TimurMuhanov/nio-15-stand/documentation/board/SERVO-1.docx

Плата контроллера SERVO-1, схема электрическая принципиальная

Примечание: 2 платы собираются бутербродом, на стойках, красными слоями плат (см. разводку) друг к другу. Между платами расстояние около 10 мм (по высоте соединительного разъёма). Платы соединяются электрически штыревым разъёмом. Направления нос-хвост указаны на рисунках.

Посадка плат на старый крепёжный уголок. Размеры плат пришлось увеличить на 3 мм в длину и ширину.

Плата периферийных устройств SERVO-2, схема электрическая принципиальная

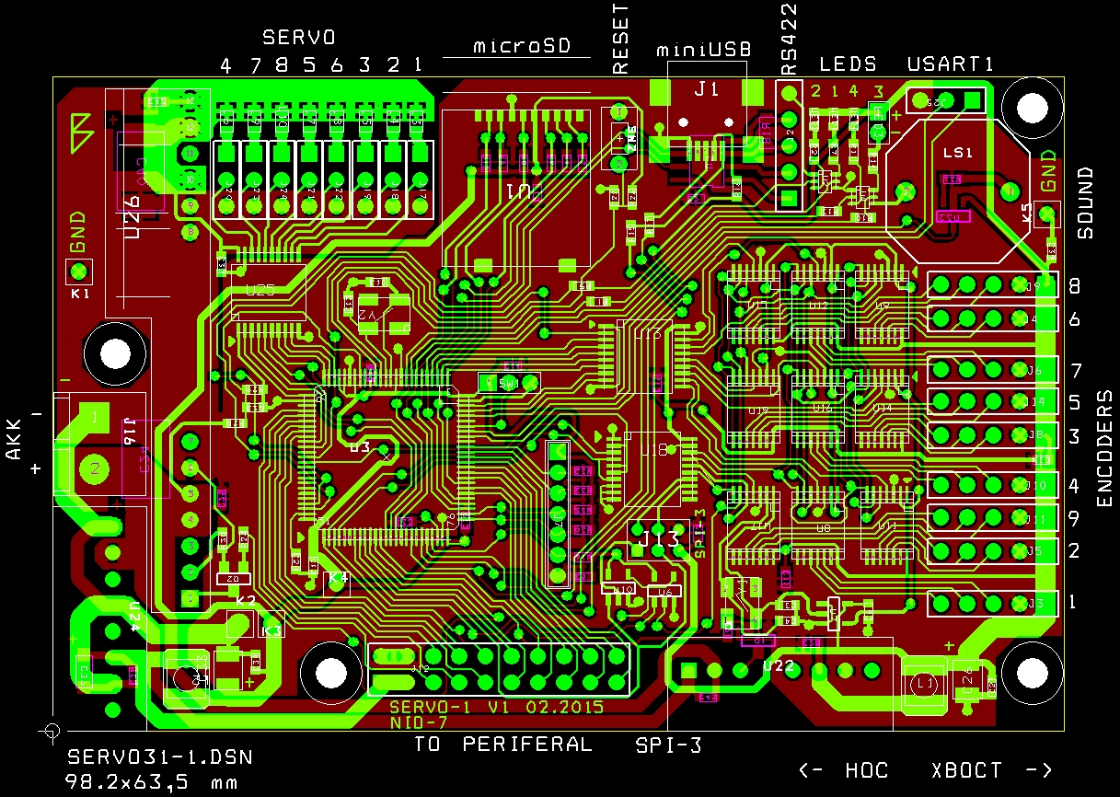
[picture p2: figure]

Разводка платы контроллера.

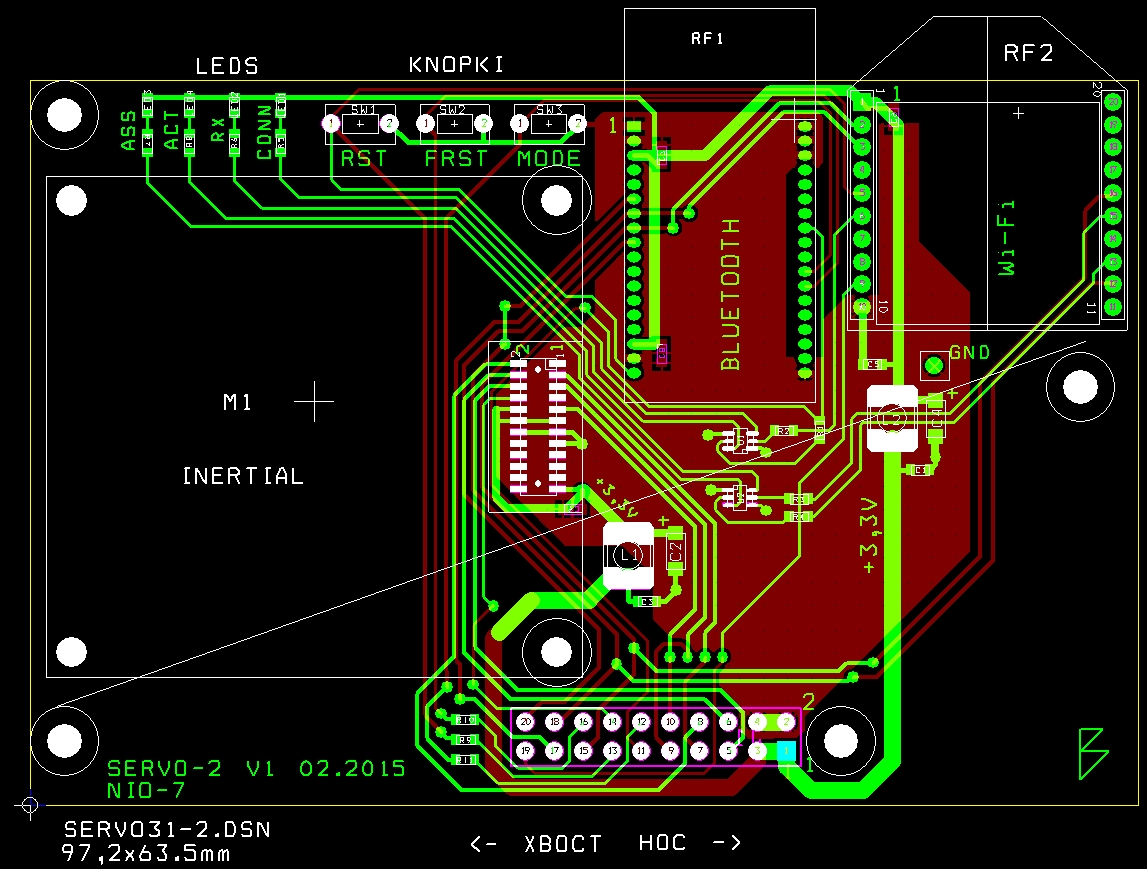
[picture p3: figure]

Разводка платы периферии
