TimurMuhanov/nio-15-stand/documentation/board/scheme1.png

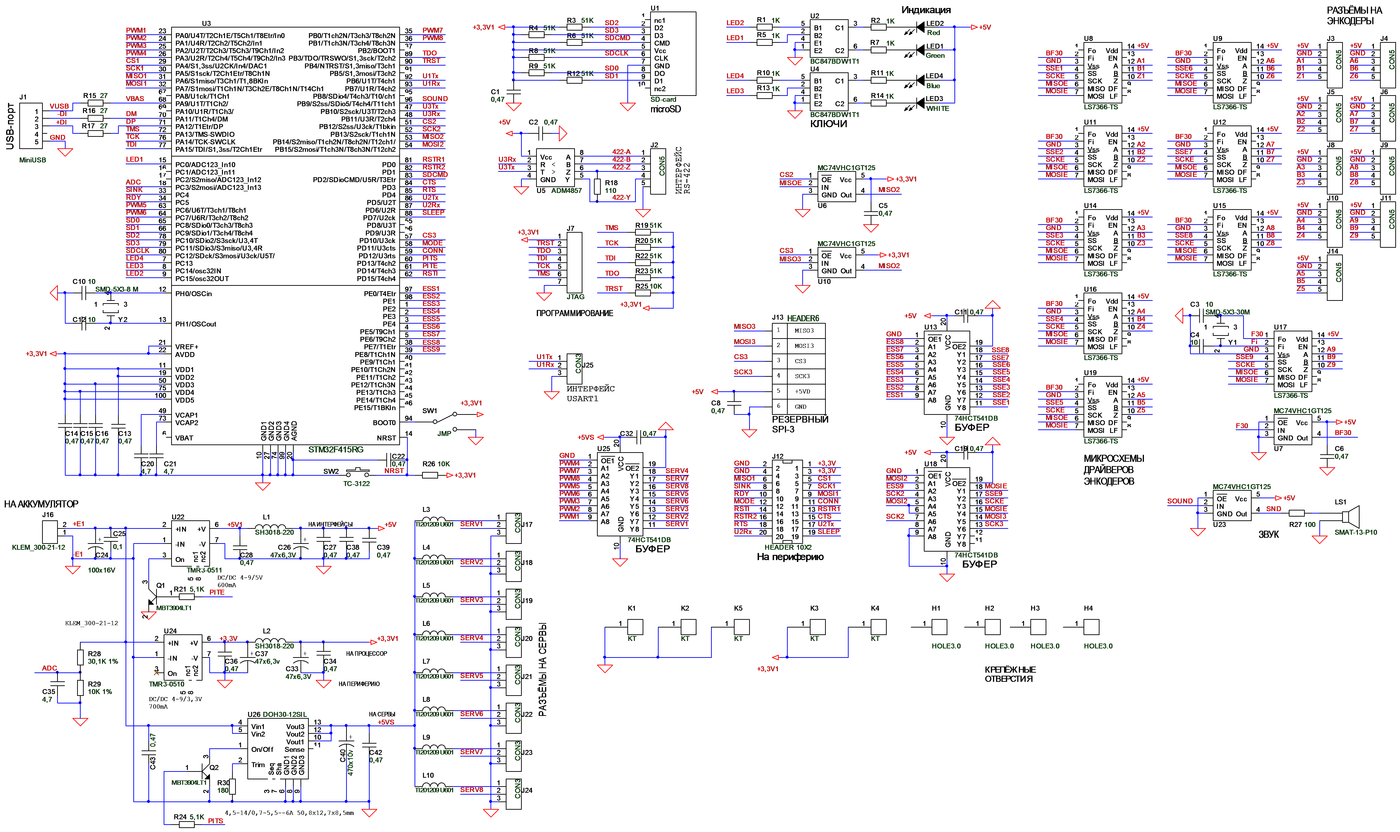
documentation/board/scheme1.png
