TimurMuhanov/nio-15-stand/documentation/board/scheme2.png

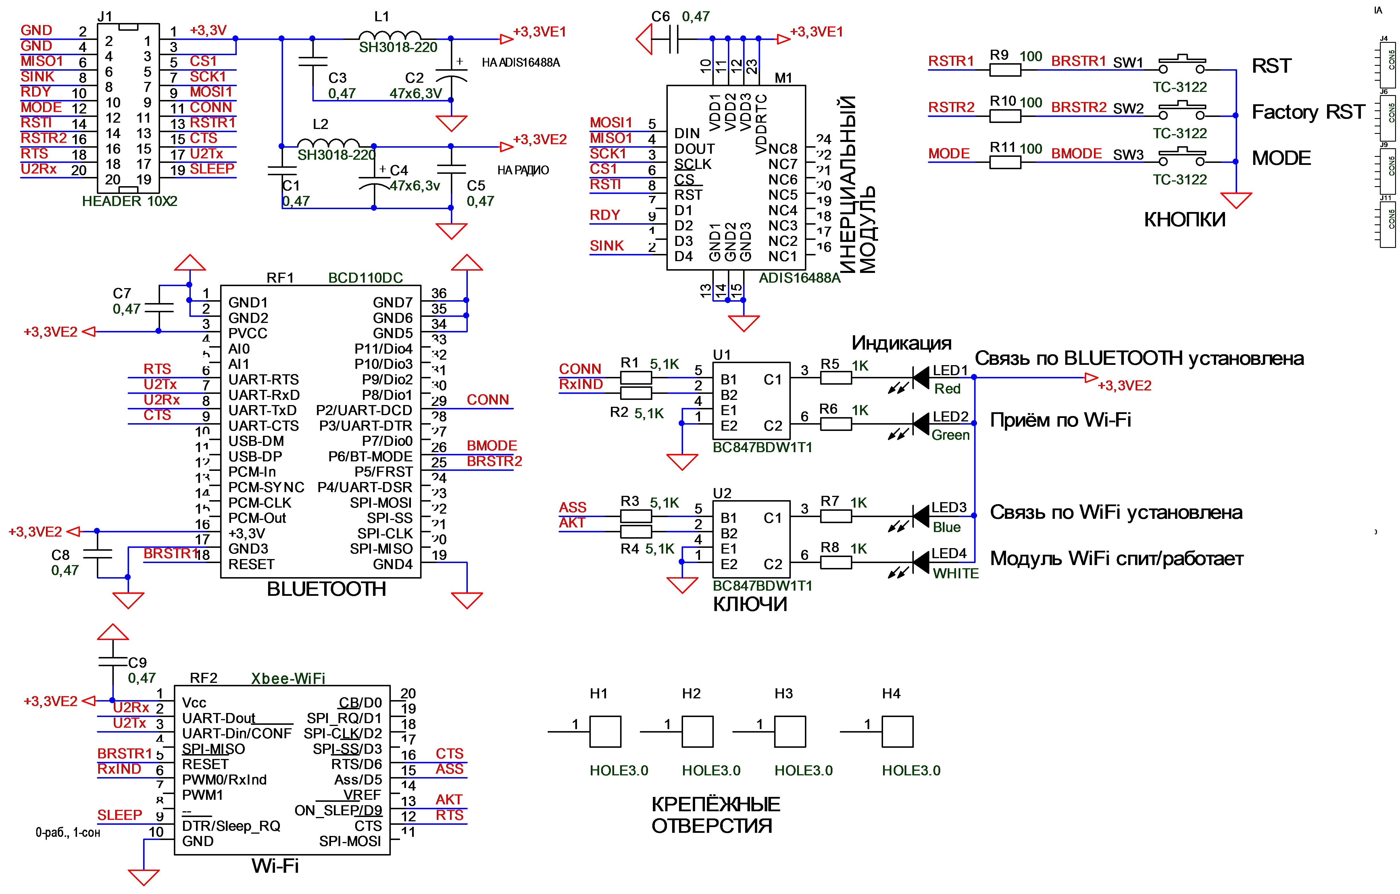
documentation/board/scheme2.png
