TimurMuhanov/nio-15-stand/firmware/driver/include/driver.h

/**	@defgroup	DRIVER
	@author		Zaripov Kamil
	@brief		Contain hardware layer
	@{ */
	
#ifndef DRIVER_H
#define DRIVER_H

#include "Battery.h"
#include "adis16488.h"
#include "led.h"
#include "ls7366.h"

#endif

/** @} */
