TimurMuhanov/nio-15-stand/firmware/system/PubSub.cpp

#include "PubSub.h"

//Topic<vectorData> Topics::accel;
//Topic<vectorData> Topics::gyro;
//Topic<vectorData> Topics::mag;
//Topic<scalarData> Topics::temp;
//Topic<scalarData> Topics::press;
//Topic<quaternionData> Topics::quat;
