TimurMuhanov/nio-15-stand/firmware/system/include/system.h

/**	@defgroup	SYSTEM
	@author		Zaripov Kamil
	@brief		Contain hardware-independent layer
	@{ */
	
#ifndef SYSTEM_H
#define SYSTEM_H

#include "Terminal.h"
#include "FileSystem.h"
#include "Connection.h"
#include "Settings.h"
#include "Log.h"
#include "Control.h"

#endif

/** @} */
