TimurMuhanov/nio-15-stand/firmware/system/include/thread.h

/**	@defgroup	CONNECTION
	@author		Zaripov Kamil
                API for threading
	@{ */

#ifndef THREAD_H
#define THREAD_H

#include "ch.hpp"
#include "chdynamic.h"
#include "hal.h"
#include <string>
#include <map>

using namespace std;

class Thread {
    public:
        static void                     loop();
};

#endif

/** @} */
