TimurMuhanov/nio-15-stand/gcs/connection/include/logger.h

#ifndef	LOGGER_H
#define	LOGGER_H


#include <QObject>
#include <QHash>
#include <QFile>


class Logger : public QObject {
    Q_OBJECT

    public:
        static Logger&			instance();

    public slots:
        void					addData(const QString& name, const double time, std::initializer_list<double> data);

    private slots:
        void                    reset();
        void                    loggingPathChange();

    private:
                                Logger(QObject *parent = 0);
                               ~Logger();
                                Logger(Logger const&);
                                Logger& operator= (Logger const&);

        QString					_rootPath;
        QString					_path;
        QHash<QString, QFile*>  _logs;
};


#endif // LOGGER_H
