TimurMuhanov/nio-15-stand/simulator/calculator/calculator.cpp

#include "calculator.h"
#include "ui_mainwindow.h"



Calculator::Calculator(QObject* parent) : QThread(parent) {
	QObject::connect(
		MainWindow::ui().startPushButton,
		SIGNAL(clicked()),
		SLOT(startStop())
	);

	QObject::connect(
		this,
		SIGNAL(newPlot(QString, double, double)),
		&MainWindow::instance(),
		SLOT(plotAdd(QString, double, double))
	);


	QObject::connect(
		this,
		SIGNAL(started()),
		this,
		SLOT(startUI())
	);
	QObject::connect(
		this,
		SIGNAL(finished()),
		this,
		SLOT(stopUI())
	);

	_isStop = false;
}

Calculator::~Calculator() {
	_isStop = true;
	wait(CALCULATOR_CLOSE_WAIT_TIME_MS);
}

Calculator& Calculator::instance() {
	static Calculator instance;
	return instance;
}

void Calculator::run() {
	while(1) {
		//qDebug() << timeAt << dtAt << timeAl << dtAl;
		if( timeAt <= timeAl && timeAl < timeAt+dtAt ) {
			updateAlgorythm();
			timeAl+=dtAl;
		}
		timeAt+=dtAt;

		// debug
		emit newPlot("mx", timeAt, Mx);
		emit newPlot("my", timeAt, My);
		emit newPlot("mz", timeAt, Mz);
		//qDebug() << "M" << Mx << My << Mz;
		emit newPlot("wx", timeAt, wx);
		emit newPlot("wy", timeAt, wy);
		emit newPlot("wz", timeAt, wz);
		//qDebug() << "w" << wx << wy << wz;
		emit newPlot("psi", timeAt, psi/M_PI*180.0);
		emit newPlot("theta", timeAt, theta/M_PI*180.0);
		emit newPlot("gamma", timeAt, gamma/M_PI*180.0);
		//qDebug() << "a" << psi/M_PI*180.0 << theta/M_PI*180.0 << gamma/M_PI*180.0;

		// calculate moments
		aer_loads_mig29_moments( atan(tan(theta)*cos(gamma))/M_PI*180.0, asin(sin(theta)*sin(gamma))/M_PI*180.0, wx*L/2/V, wy*L/2/V, wz*ba/V, fi, df, da, dr, -0.0177 );

		// calculate angular rate
		wx = wxPrevious+(wyPrevious*wzPrevious*(Jy-Jz)/Jx+Mx/Jx)*dtAt;
		wy = wyPrevious+(wzPrevious*wxPrevious*(Jz-Jx)/Jy+My/Jy)*dtAt;
		wz = wzPrevious+(wxPrevious*wyPrevious*(Jx-Jy)/Jz+Mz/Jz)*dtAt;

		wxPrevious = wx;
		wyPrevious = wy;
		wzPrevious = wz;

		// calculate angles
		psi = psiPrevious+( (wz*sin(gammaPrevious)-wy*cos(gammaPrevious))/sin(thetaPrevious) )*dtAt;
		theta = thetaPrevious+( wy*sin(gammaPrevious)+wz*cos(gammaPrevious) )*dtAt;
		gamma = gammaPrevious+( wx+(wy*cos(gammaPrevious)-wz*sin(gammaPrevious))*cos(thetaPrevious)/sin(thetaPrevious) )*dtAt;

		if( abs(psi)>2*M_PI ) psi= fmod(psi, 2*M_PI);
		if( abs(theta)>2*M_PI ) theta= fmod(theta, 2*M_PI);
		if( abs(gamma)>2*M_PI )	gamma= fmod(gamma, 2*M_PI);
		psiPrevious = psi;
		thetaPrevious = theta;
		gammaPrevious = gamma;

		if( _isStop || timeAt > MainWindow::ui().endTimeSpinBox->value() ) {
			_isStop = false;
			return;
		}
	}
}

extern float vDelta_o[6];
extern float dt;

void Calculator::startStop() {
	if( isRunning() ) {
		_isStop = true;
		wait(CALCULATOR_CLOSE_WAIT_TIME_MS);
	} else {
		reset();
		start();
	}
}

void Calculator::startUI() {
	MainWindow::ui().inputGroupBox->setEnabled(false);
	MainWindow::ui().startPushButton->setText("Pause");
}

void Calculator::stopUI() {
	MainWindow::ui().inputGroupBox->setEnabled(true);
	MainWindow::ui().startPushButton->setText("Start");
}



typedef struct { 		         // input data struct
	 float W[3];        // wx, wy, wz до фильтра Калмана [deg/s]
	 float Wk[3];       // wx, wy, wz после фильтра Калмана [deg/s]
	 float PHI[3];      // gamma, teta, psi от фильтра Калмана [deg]
	 float encData[3];  // данные - encoder1,2,3 [deg]
	 // encoder1 - крен
	 // encoder2 - рыскание
	 // encoder3 - тангаж
} _DLMIN;

typedef struct { 		         // out data struct
	 float ANGL[6];	     // углы отклонения органов управления в [deg]
	 // 1 - правый элерон			0
	 // 2 - стабилизатор правый	1
	 // 3 - левый элерон			2
	 // 4 - руль направления		3
	 // 5 - стабилизатор левый		4
	 // 6 - не используется		5
} _DLMOUT;
_DLMIN InData;
_DLMOUT OutData;

extern "C" int umain(const _DLMIN *InData, _DLMOUT *OutData);

void Calculator::updateAlgorythm() {
	InData.Wk[0] = wx;
	InData.Wk[1] = wy;
	InData.Wk[2] = wz;
	InData.encData[0] = gamma;
	InData.encData[1] = psi;
	InData.encData[2] = theta;
	//qDebug() << "input" << InData.encData[0] << InData.encData[1] << InData.encData[2];
	umain( (const _DLMIN*)&InData, (_DLMOUT*)&OutData);
	//   fi - angle of GO deflection (deg) [-35deg 10deg]
	//   df - differentional GO deflection (deg)
	//   da - aileron deflection (deg) [-20deg 20deg]
	//   dr - rudder deflection (deg) [-25deg 25deg]

	//qDebug() << "output" << OutData.ANGL[0] << OutData.ANGL[1] << OutData.ANGL[2] << OutData.ANGL[3] << OutData.ANGL[4] << OutData.ANGL[5];
	fi = (OutData.ANGL[1]+OutData.ANGL[4])/2;
	df = (OutData.ANGL[1]-OutData.ANGL[4])/2;
	da = (OutData.ANGL[0]-OutData.ANGL[2])/2;
	dr = OutData.ANGL[3];

	emit newPlot("fi", timeAt, fi);
	emit newPlot("df", timeAt, df);
	emit newPlot("da", timeAt, da);
	emit newPlot("dr", timeAt, dr);
	emit newPlot("servo1", timeAt, OutData.ANGL[0]);
	emit newPlot("servo2", timeAt, OutData.ANGL[1]);
	emit newPlot("servo3", timeAt, OutData.ANGL[2]);
	emit newPlot("servo4", timeAt, OutData.ANGL[3]);
	emit newPlot("servo5", timeAt, OutData.ANGL[4]);
}

void Calculator::reset() {
	Jx = MainWindow::ui().JxDoubleSpinBox->value();
	Jy = MainWindow::ui().JyDoubleSpinBox->value();
	Jz = MainWindow::ui().JzDoubleSpinBox->value();
	rho = MainWindow::ui().rhoDoubleSpinBox->value();
	V = MainWindow::ui().VDoubleSpinBox->value();
	S = MainWindow::ui().SDoubleSpinBox->value();
	L = MainWindow::ui().LDoubleSpinBox->value();
	ba = MainWindow::ui().baDoubleSpinBox->value();

	Mx = MxPrevious = 0;
	My = MyPrevious = 0;
	Mz = MzPrevious = 0;

	wx = wxPrevious = MainWindow::ui().wxDoubleSpinBox->value();
	wy = wyPrevious = MainWindow::ui().wyDoubleSpinBox->value();
	wz = wzPrevious = MainWindow::ui().wzDoubleSpinBox->value();

	theta = thetaPrevious = (MainWindow::ui().thetaDoubleSpinBox->value())/180*M_PI;
	psi = psiPrevious = (MainWindow::ui().psiDoubleSpinBox->value())/180*M_PI;
	gamma = gammaPrevious = (MainWindow::ui().gammaDoubleSpinBox->value())/180*M_PI;

	dtAt = MainWindow::ui().tAtDoubleSpinBox->value();
	dtAl = MainWindow::ui().tAlDoubleSpinBox->value();
	timeAl = 0;
	timeAt = 0;

	fi = MainWindow::ui().fiDoubleSpinBox->value();
	df = MainWindow::ui().dfDoubleSpinBox->value();
	da = MainWindow::ui().daDoubleSpinBox->value();
	dr = MainWindow::ui().drDoubleSpinBox->value();
	vDelta_o[0] = da;
	vDelta_o[2] = -da;
	vDelta_o[1] = fi+df;
	vDelta_o[3] = dr;
	vDelta_o[4] = fi-df;
	dt = dtAl;

	MainWindow::instance().reset();
}




void Calculator::aer_loads_mig29_moments( double al, double be, double wx, double wy, double wz, double fi, double df, double da, double dr, double dx ) {
	//qDebug() << "aer_loads_mig29_moments" << al << be << wx << wy << wz << fi << df << da << dr << dx;
	// MIG-29 low subsonic aerodynamic loads mathematical model (Syrovatsky)
	//   Input
	//   al - angle of attack (deg) [-5deg 90deg]
	//   be - angle of sideslip (deg) [-20deg 20deg]
	//   wx - roll rate (undimensioanal)
	//   wy - yaw rate (undimensioanal)
	//   wz - pitch rate (undimensioanal)
	//   fi - angle of GO deflection (deg) [-35deg 10deg]
	//   df - differentional GO deflection (deg)
	//   da - aileron deflection (deg) [-20deg 20deg]
	//   dr - rudder deflection (deg) [-25deg 25deg]
	//   dx - CG position displacement
	//   Output
	//   cx - aeodynamic drag coefficient in body fixed frame
	//   cy - aeodynamic drag coefficientin body fixed frame
	//   cz - aeodynamic drag coefficientin body fixed frame
	//   mx - rolling moment coefficient in body fixed frame
	//   my - yawing moment coefficient in body fixed frame
	//   mz - pitching moment coefficient in body fixed frame

	double cx, cy, cz, mx, my, mz;

	cx = cx_al(al);
	cy = cy_al_fi(al,fi);
	cz = cz0(al) + dcz_al_be(al,be) + dcz_da(al)*da + dcz_al_dr(al,dr) + dcz_al_fi(al,fi)*df;
	mx = mx0(al) + dmx_al_be(al,be) + dmx_da(al)*da + dmx_al_dr(al,dr) + dmx_al_fi(al,fi)*df + mxwx_al(al)*wx + mxwy_al(al)*wy;
	my = my0(al) + dmy_al_be(al,be) + dmy_da(al)*da + dmy_al_dr(al,dr) + dmy_al_fi(al,fi)*df + mywx_al(al)*wx + mywy_al_fi(al,fi)*wy;
	mz = mz_al_fi(al,fi) + dmz_al_be(al,be) + mzwz_al(al)*wz + dx*cy;

	Mx = mx*S*L*rho*V*V*0.5;
	My = my*S*L*rho*V*V*0.5;
	Mz = mz*S*ba*rho*V*V*0.5;

	/*qDebug() << "mx" << Mx << mx;
	qDebug() << "my" << My << my;
	qDebug() << "mz"  << Mz << mz;*/
}




// ################## c_x #######################
double Calculator::cx_al( double al ) {
	static double al0[20] = {-5, 0, 5, 10, 15, 20, 25, 30, 35, 40, 45, 50, 55, 60, 65, 70, 75, 80, 85, 90};
	static double cx[20] = {0.05, 0.023, 0, -0.03, -0.06, -0.08, -0.08, -0.08, -0.08, -0.07, -0.06, -0.05, -0.04, -0.03, -0.02, -0.01, 0, 0, 0, 0};
	return interp1l(al0,cx,al);
}




// ################## c_y #######################
double Calculator::cy_al_fi( double al, double fi ) {
	static double al0[26] = {0, 2, 4, 6, 8, 10, 12, 14, 16, 18, 20, 22, 24, 26, 28, 30, 32, 34, 36, 38, 40, 42, 44, 46, 48, 50};
	static double fi0[7] = {-30, -28, -24, -20, -26, -12, 0};
	static double cy[182] = {
		-0.2288,  -0.1901,  -0.2044,  -0.1689,  -0.1436,  -0.1155,  -0.0399,
		-0.0686,  -0.0620,  -0.0454,  -0.0228,   0.0030,   0.0320,   0.1137,
		0.0698,   0.0776,   0.0953,   0.1193,   0.1441,   0.1775,   0.2586,
		0.2123,   0.2203,   0.2363,   0.2655,   0.2871,   0.3254,   0.4044,
		0.3566,   0.3600,   0.3761,   0.4113,   0.4310,   0.4709,   0.5481,
		0.4972,   0.4928,   0.5108,   0.5477,   0.5688,   0.6061,   0.6844,
		0.6260,   0.6163,   0.6358,   0.6684,   0.6936,   0.7267,   0.8068,
		0.7393,   0.7299,   0.7503,   0.7775,   0.8057,   0.8366,   0.9174,
		0.8423,   0.8380,   0.8601,   0.8852,   0.9126,   0.9440,   1.0254,
		0.9460,   0.9454,   0.9710,   0.9989,   1.0210,   1.0537,   1.1388,
		1.0569,   1.0536,   1.0814,   1.1114,   1.1300,   1.1631,   1.2551,
		1.1671,   1.1604,   1.1852,   1.2154,   1.2354,   1.2681,   1.3662,
		1.2701,   1.2646,   1.2839,   1.3173,   1.3399,   1.3716,   1.4717,
		1.3657,   1.3632,   1.3823,   1.4233,   1.4436,   1.4749,   1.5760,
		1.4439,   1.4430,   1.4673,   1.5110,   1.5266,   1.5627,   1.6653,
		1.4845,   1.4873,   1.5138,   1.5497,   1.5654,   1.6099,   1.7119,
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
		  0.042,  0.0415,   0.014,  0.0032,   0.028, 0,  0.0013,  0.0019,  0.0073,  0.0331,  0.0114,
		 0.0515,  0.0455,  0.0167,  0.0085,  0.0192, 0,  0.0005,   0.014,  0.0079,  0.0464,  0.0168 };
	return interp2l( (double*)be0, 11, (double*)al0, 26, (double*)dmz, be, al);
}

double Calculator::mzwz_al( double al ) {
	static double al0[20] = {-5, 0, 5, 10, 15, 20, 25, 30, 35, 40, 45, 50, 55, 60, 65, 70, 75, 80, 85, 90};
	static double mzwz[20] = {-4.4, -3.6, -3.2, -3.9, -4.8, -4.6, -4, -6.1, -5, -7.7, -8.5, -9, -7, -7, -5.7, -6.2, -6.2, -6.2, -6.2, -6.2};
		
	return interp1l(al0, mzwz, al);
}

double Calculator::interp1l( double* x, int xNum, double* y, int yNum, double xi ) {
	int k;

	if( xi <= x[0] )
		return y[0];
	if( xi >= x[xNum-1] )
		return y[yNum-1];

	for( k=0; k<xNum; k++ ) {
		if( xi >= x[k] && xi < x[k+1] )
			break;
	}

	return y[k] + (xi-x[k])/(x[k+1]-x[k])*(y[k+1]-y[k]);
}

double Calculator::interp1l( double x[20], double y[20], double xi ) {
	int k;

	if( xi <= x[0] )
		return y[0];
	if( xi >= x[19] )
		return y[19];

	for( k=0; k<20; k++ ) {
		if( xi >= x[k] && xi < x[k+1] )
			break;
	}

	return y[k] + (xi-x[k])/(x[k+1]-x[k])*(y[k+1]-y[k]);
}

#define	MAT(m,n,i,j)  (*((m)+(i)*(n)+(j)))

double Calculator::interp2l( double* x, int xNum, double* y, int yNum, double* z, double xi, double yi ) {
	int k1,k2;
	//MAT(z, xNum, , );

	if( xi <= x[0] || xi >= x[xNum-1] ) {
		if( xi <= x[0] )
			k1 = 0;
		if( xi >= x[xNum-1] )
			k1 = xNum-1;

		if( yi <= y[0] )
			return MAT(z, xNum, 0, k1);
		if( yi >= y[yNum-1] )
			return MAT(z, xNum, yNum-1, k1 );

		for( k2=0; k2<yNum; k2++ ) {
			if( yi >= y[k2] && yi < y[k2+1] )
				break;
		}

		return MAT(z, xNum, k2, k1) + (yi-y[k2])/(y[k2+1]-y[k2])*(MAT(z, xNum, k2+1, k1)-MAT(z, xNum, k2, k1));
	}

	if( yi <= y[0] || yi >= y[yNum-1] ) {
		if( yi <= y[0] )
			k2 = 0;
		if( yi >= y[yNum-1] )
			k2 = yNum-1;

		if( xi <= x[0] )
			return MAT(z, xNum, k2, 0);
		if( xi >= x[xNum-1] )
			return MAT(z, xNum, k2, xNum-1);

		for( k1=0; k1<xNum; k1++ ) {
			if( xi >= x[k1] && xi < x[k1+1] )
				break;
		}

		return MAT(z, xNum, k2, k1) + (xi-x[k1])/(x[k1+1]-x[k1])*(MAT(z, xNum, k2, k1+1)-MAT(z, xNum, k2, k1));
	}

	for( k1=0; k1<xNum; k1++ ) {
		if( xi >= x[k1] && xi <= x[k1+1] )
			break;
	}
	for( k2=0; k2<yNum; k2++ ) {
		if( yi >= y[k2] && yi <= y[k2+1] )
			break;
	}

	double s1 = (xi-x[k1])/(x[k1+1]-x[k1]);
	double s2 = (yi-y[k2])/(y[k2+1]-y[k2]);
	double z1  = MAT(z, xNum, k2, k1)+(MAT(z, xNum, k2, k1+1)-MAT(z, xNum, k2, k1))*s1;
	double z2  = MAT(z, xNum, k2+1, k1)+(MAT(z, xNum, k2+1, k1+1)-MAT(z, xNum, k2+1, k1))*s1;
	return z1 + (z2-z1)*s2;
}
