TimurMuhanov/nio-15-stand/(commit log)

2016-03-24 uart test
2016-03-24 Imu test unstabile
    [encoder.csv]
2016-03-24 Imu test stabile
    [encoder.csv]
2016-03-24 Фильтр неработает, крутится. Стабиле.
2016-03-25 Фильтр работает, но дрожжит.
2016-03-31 Попытка измерить дрожжание... Зачем? Не знаю...
2016-04-07 почти не трясется
2016-04-07 разобраться с уводом
2017-09-21 Тестовый проект для stm32f1 измененна версия ChibiOS.
2017-09-21 Изменение/добавление README.MD; Универсализация пути в cmake.
2017-09-23 ChibiOS kernel changed from nil to rt. Now it doesn't crash in test board.
    [board.c, board.h, chconf.h, test.cpp]
2017-09-23 Изменили инструкции к сборке. Переместили платформенно зависимую часть в board. Автоматизировали процесс загрузки флеша.
2017-10-05 Fixed NoNameChina_STM32F103 configs, tested virtual com port.
    [board.h, chconf.h, mcuconf.h, test.cpp]
2017-10-05 Добавлены файлы документации.
2017-10-05 Шлем данные по serial_usb.
2017-10-05 Контроллер слушает данные по serial_usb.
2017-10-12 Переходим на STM32F415RG
2017-10-14 F415 board led test.
2017-10-14 Fixed F415 board startup, updated gdb scripts.
